westrik/MFW007B/README.md

# MFW007B
NA-01 Rev B (for JLCPCB assembly)
