westrik/MFW007B/MFW007B.kicad_pcb

## KiCad design MFW007B.kicad_pcb (2021-06-15)

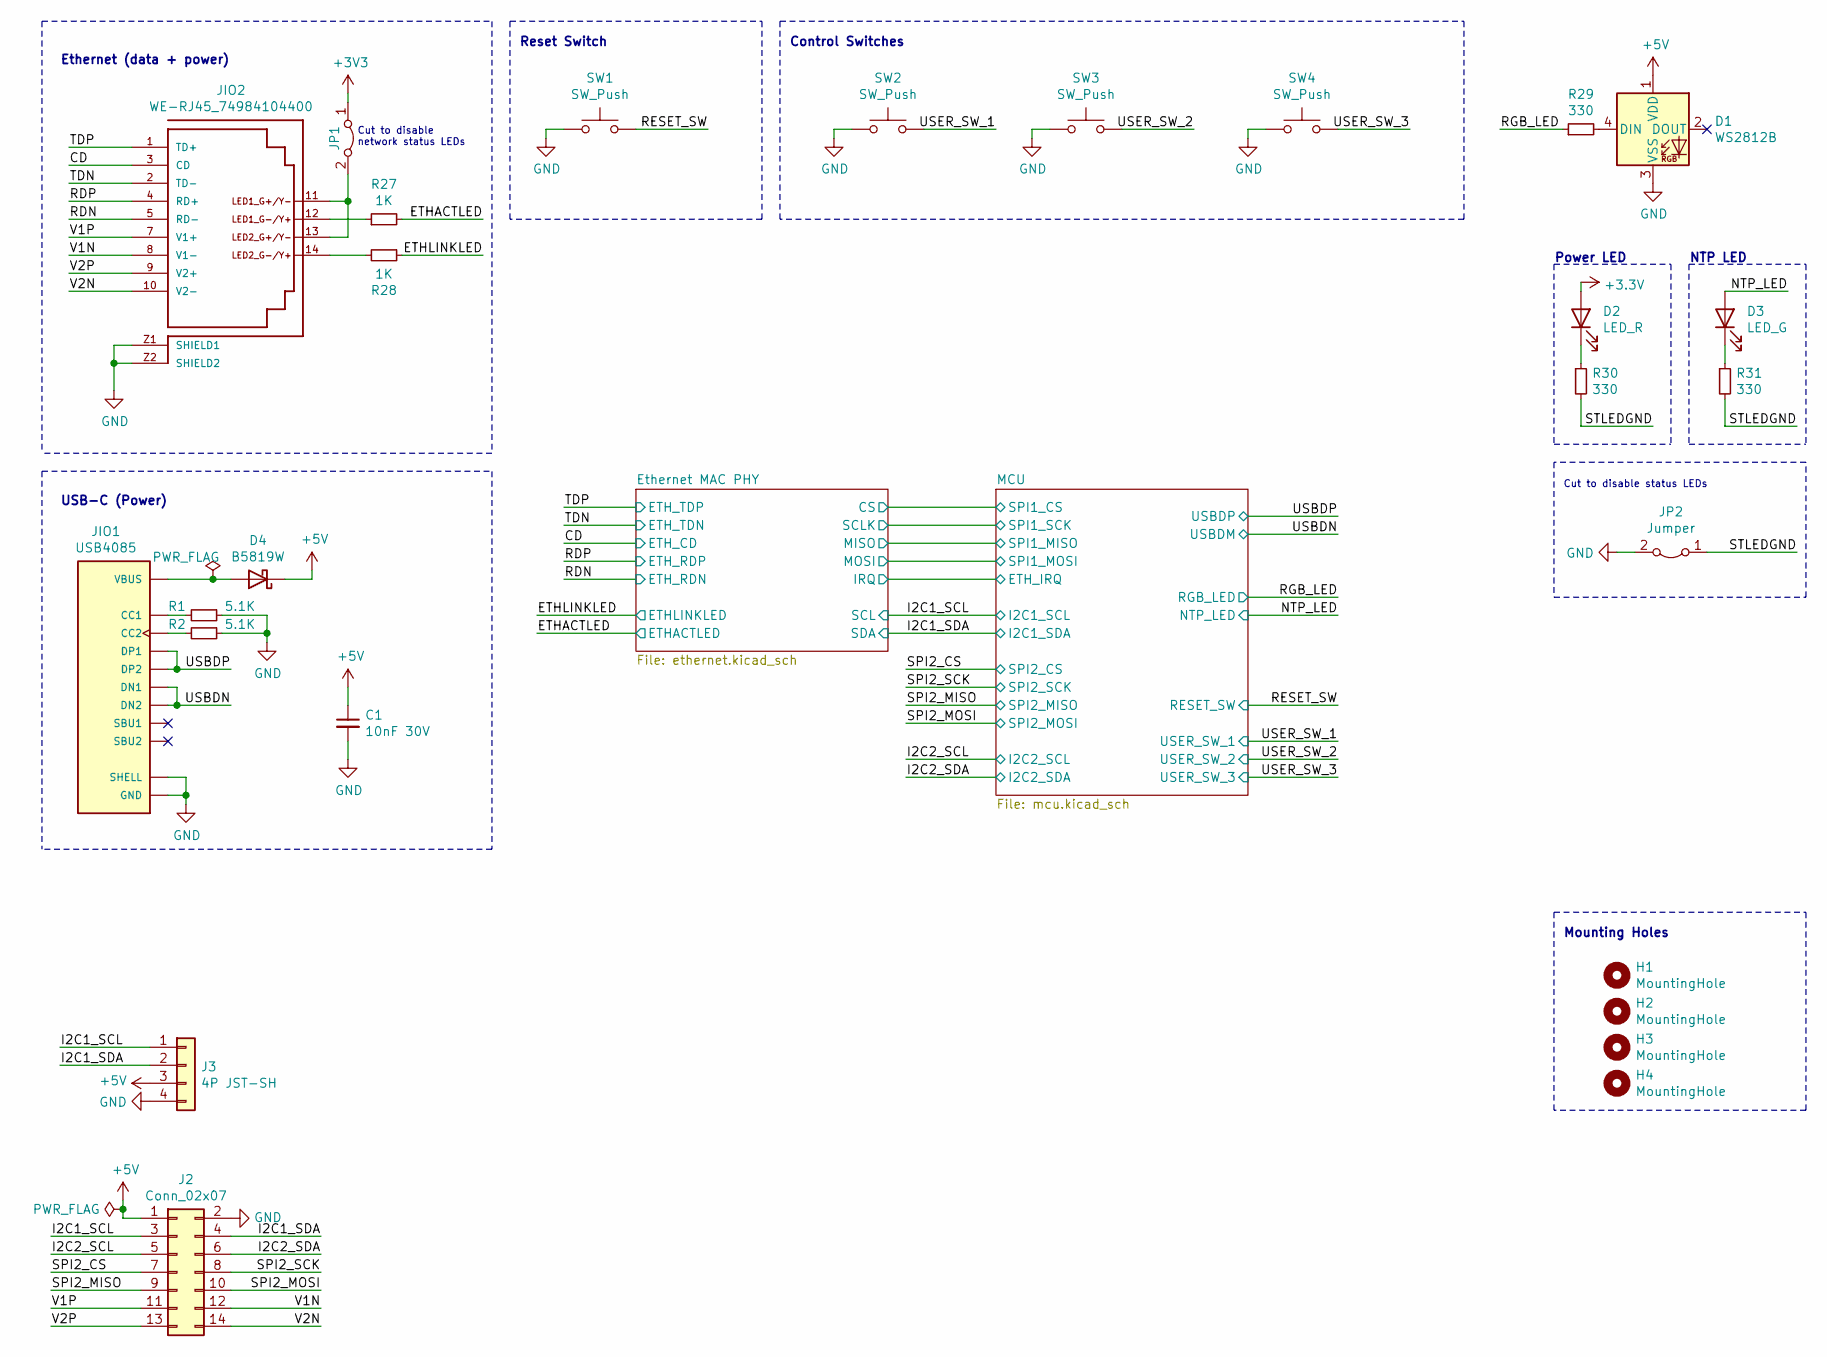
[picture p1: schematic MFW007B.kicad_sch, NA-01 Time Computer]

Parts:
C1: 10nF 30V; C_0805_2012Metric; LCSC Part Number C1710
D1: WS2812B; LED_WS2812B_PLCC4_5.0x5.0mm_P3.2mm; LCSC Part Number N/A
D2: LED_R; LED_0603_1608Metric; LCSC Part Number C2286
D3: LED_G; LED_0603_1608Metric; LCSC Part Number C72043
D4: B5819W; D_SOD-123; LCSC Part Number C8598
H1, H2, H3, H4: MountingHole; MountingHole_2.7mm_M2.5; LCSC Part Number N/A
J2: Conn_02x07; PinHeader_2x07_P2.54mm_Vertical; LCSC Part Number N/A
J3: 4P JST-SH; JST_SH_SM04B-SRSS-TB_1x04-1MP_P1.00mm_Horizontal; LCSC Part Number N/A
JIO1: USB4085; GCT_USB4085-GF-A_REVA; Manufacturer Part Number green/yellow-green/yellow; LCSC Part Number N/A
JIO2: WE-RJ45_74984104400; 74984104400; PART-NUMBER 74984104400; LCSC Part Number N/A
JP1, JP2: Jumper; SolderJumper-2_P1.3mm_Bridged_RoundedPad1.0x1.5mm; LCSC Part Number N/A
R1, R2: 5.1K; R_0402_1005Metric; LCSC Part Number C25905
R27, R28: 1K; R_0402_1005Metric
R29, R30, R31: 330; R_0402_1005Metric
SW1, SW2, SW3, SW4: SW_Push; PTS647SK38SMTR2LFS; LCSC Part Number N/A

Connections:
+5V: C1.1, D1.1 (VDD), D4.1 (K), J2.1, J3.3; also elsewhere on the board
/CD: JIO2.3 (CD); also elsewhere on the board
/ETHACTLED: R27.2; also elsewhere on the board
/ETHLINKLED: R28.1; also elsewhere on the board
/I2C1_SCL: J2.3, J3.1; also elsewhere on the board
/I2C1_SDA: J2.4, J3.2; also elsewhere on the board
/I2C2_SCL: J2.5; also elsewhere on the board
/I2C2_SDA: J2.6; also elsewhere on the board
/NTP_LED: D3.2 (A); also elsewhere on the board
/RDN: JIO2.5 (RD-); also elsewhere on the board
/RDP: JIO2.4 (RD+); also elsewhere on the board
/RESET_SW: SW1.2; also elsewhere on the board
/RGB_LED: R29.1; also elsewhere on the board
/SPI2_CS: J2.7; also elsewhere on the board
/SPI2_MISO: J2.9; also elsewhere on the board
/SPI2_MOSI: J2.10; also elsewhere on the board
/SPI2_SCK: J2.8; also elsewhere on the board
/STLEDGND: JP2.1 (A), R30.2, R31.2
/TDN: JIO2.2 (TD-); also elsewhere on the board
/TDP: JIO2.1 (TD+); also elsewhere on the board
/USBDN: JIO1.A7 (DN1), JIO1.B7 (DN2); also elsewhere on the board
/USBDP: JIO1.A6 (DP1), JIO1.B6 (DP2); also elsewhere on the board
/USER_SW_1: SW2.2; also elsewhere on the board
/USER_SW_2: SW3.2; also elsewhere on the board
/USER_SW_3: SW4.2; also elsewhere on the board
/V1N: J2.12, JIO2.8 (V1-)
/V1P: J2.11, JIO2.7 (V1+)
/V2N: J2.14, JIO2.10 (V2-)
/V2P: J2.13, JIO2.9 (V2+)
GND: C1.2, D1.3 (VSS), J2.2, J3.4, JIO1.A1 (GND), JIO1.A12 (GND), JIO1.B1 (GND), JIO1.B12 (GND), JIO1.P1 (SHELL), JIO1.P2 (SHELL), JIO1.P3 (SHELL), JIO1.P4 (SHELL), JIO2.Z1 (SHIELD1), JIO2.Z2 (SHIELD2), JP2.2 (B), R1.1, R2.1, SW1.1, SW2.1, SW3.1, SW4.1; also elsewhere on the board
unnamed: D1.4 (DIN), R29.2
unnamed: D2.1 (K), R30.1
unnamed: D3.1 (K), R31.1
unnamed: D4.2 (A), JIO1.A4 (VBUS), JIO1.A9 (VBUS), JIO1.B4 (VBUS), JIO1.B9 (VBUS)
unnamed: JIO1.A5 (CC1), R1.2
unnamed: JIO1.B5 (CC2), R2.2
unnamed: JIO2.11, JIO2.13, JP1.2 (B)
unnamed: JIO2.12, R27.1
unnamed: JIO2.14, R28.2
no_connect_(D1-Pad2): D1.2 (DOUT)
no_connect_(JIO1-PadA8): JIO1.A8 (SBU1)
no_connect_(JIO1-PadB8): JIO1.B8 (SBU2)

Notes on the sheet:
Ethernet (data + power)
USB-C (Power)
Cut to disable network status LEDs
Reset Switch
Control Switches
Power LED
Cut to disable status LEDs
Mounting Holes
NTP LED

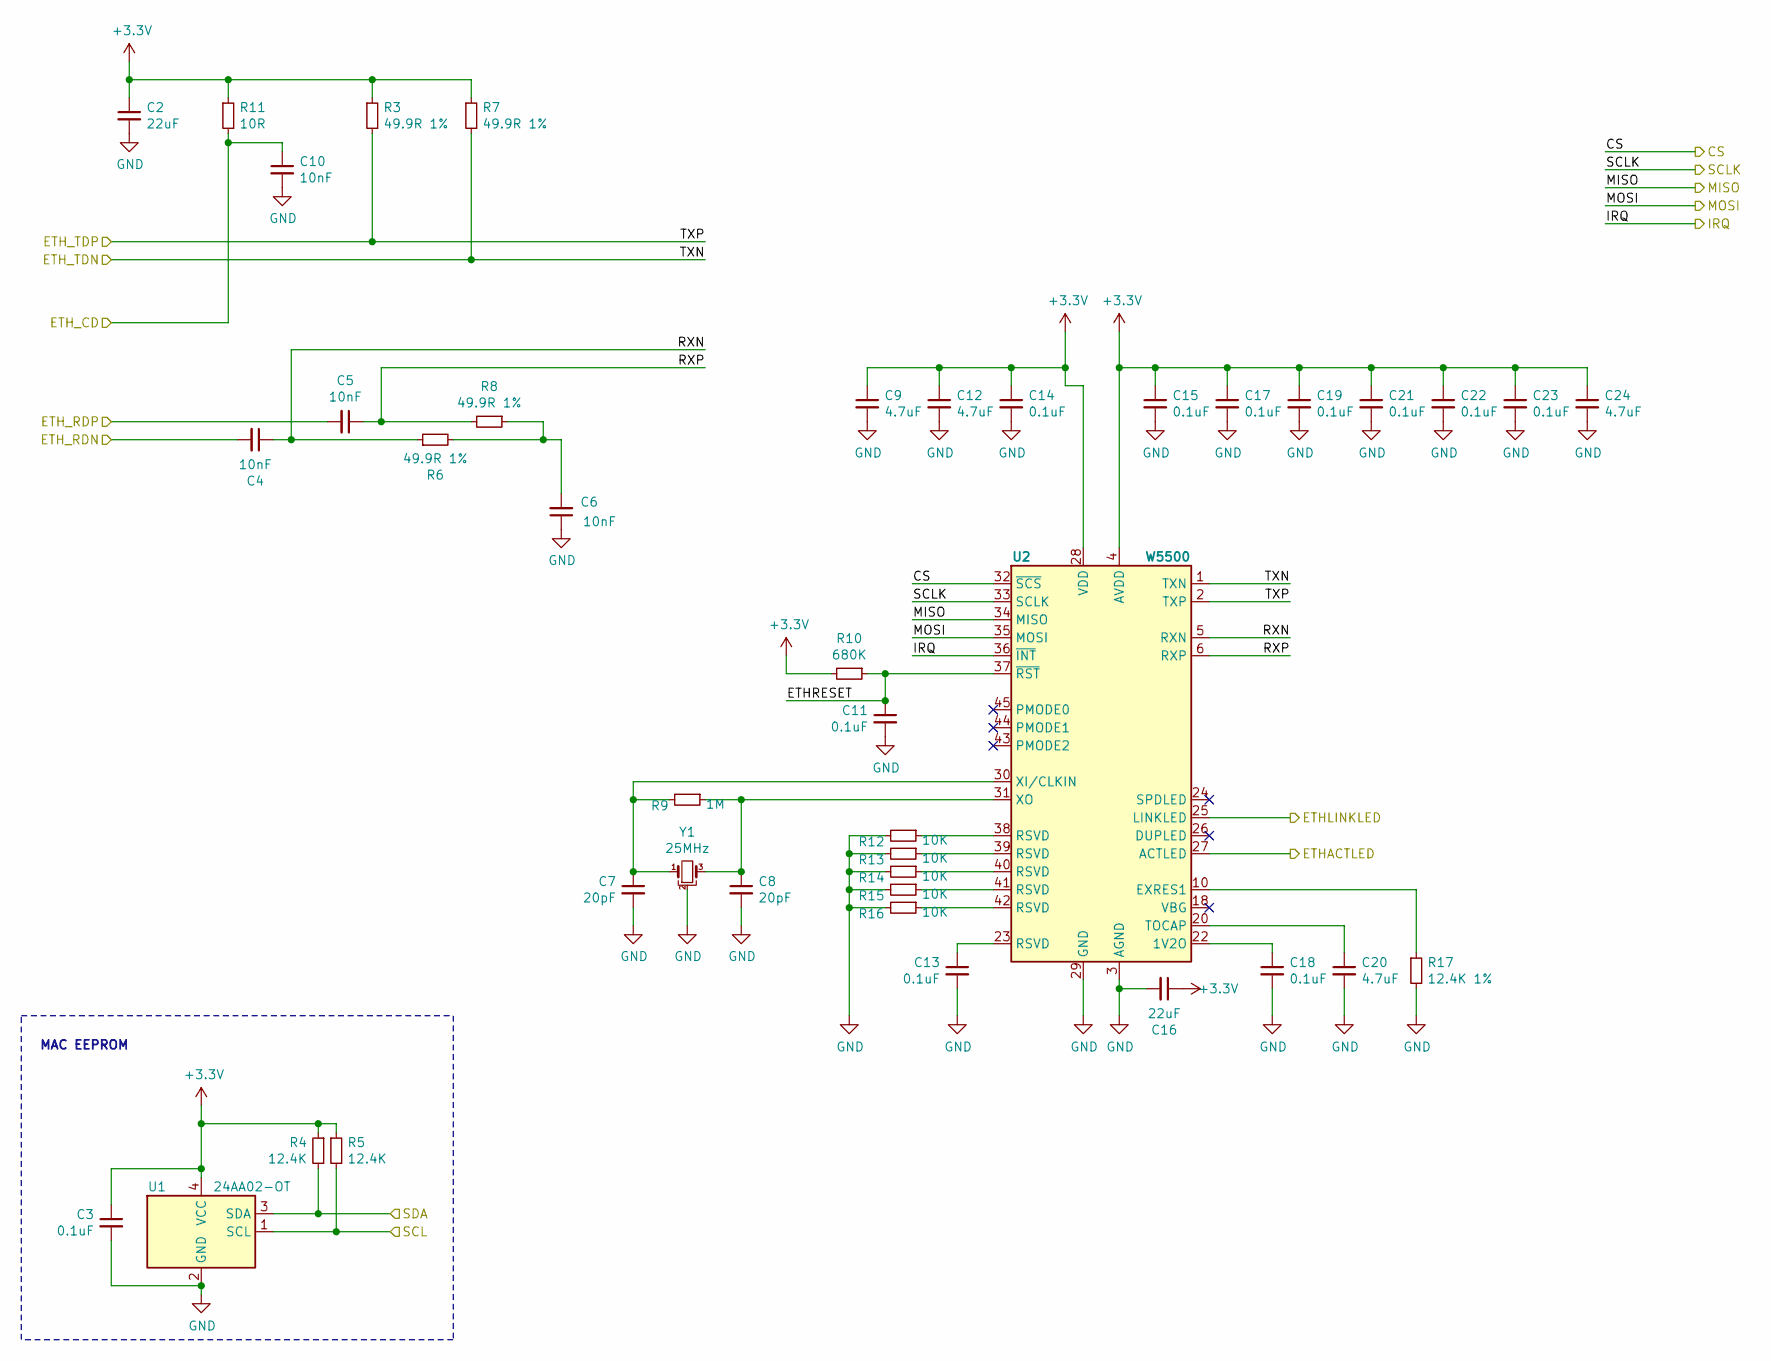
[picture p2: schematic ethernet.kicad_sch, NA-01 Time Computer]

Parts:
C2, C16: 22uF; C_0805_2012Metric; LCSC Part Number C59461
C3, C11, C13, C14, C15, C17, C18, C19, C21, C22, C23: 0.1uF; C_0402_1005Metric; LCSC Part Number C1525
C4, C5, C6, C10: 10nF; C_0402_1005Metric; LCSC Part Number C15195
C7, C8: 20pF; C_0402_1005Metric; LCSC Part Number C1554
C9, C12, C20, C24: 4.7uF; C_0402_1005Metric; LCSC Part Number C23733
R3, R6, R7, R8: 49.9R 1%; R_0402_1005Metric; LCSC Part Number C25120
R4, R5: 12.4K; R_0402_1005Metric
R9: 1M; R_0402_1005Metric
R10: 680K; R_0603_1608Metric
R11: 10R; R_0402_1005Metric
R12, R13, R14, R15, R16: 10K; R_0402_1005Metric
R17: 12.4K 1%; R_0402_1005Metric
U1: 24AA02-OT; SOT-23-5
U2: W5500; LQFP-48_7x7mm_P0.5mm
Y1: 25MHz; Crystal_SMD_3225-4Pin_3.2x2.5mm

Connections:
/CD: C10.1, R11.2; also elsewhere on the board
/ETHACTLED: U2.27 (ACTLED); also elsewhere on the board
/ETHLINKLED: U2.25 (LINKLED); also elsewhere on the board
/Ethernet MAC PHY/CS: U2.32 (~SCS); also elsewhere on the board
/Ethernet MAC PHY/ETHRESET: C11.1, R10.1, U2.37 (~RST)
/Ethernet MAC PHY/IRQ: U2.36 (~INT); also elsewhere on the board
/Ethernet MAC PHY/MISO: U2.34 (MISO); also elsewhere on the board
/Ethernet MAC PHY/MOSI: U2.35 (MOSI); also elsewhere on the board
/Ethernet MAC PHY/RXN: C4.1, R6.1, U2.5 (RXN)
/Ethernet MAC PHY/RXP: C5.1, R8.2, U2.6 (RXP)
/Ethernet MAC PHY/SCLK: U2.33 (SCLK); also elsewhere on the board
/I2C1_SCL: R5.2, U1.1 (SCL); also elsewhere on the board
/I2C1_SDA: R4.2, U1.3 (SDA); also elsewhere on the board
/RDN: C4.2; also elsewhere on the board
/RDP: C5.2; also elsewhere on the board
/TDN: R7.2, U2.1 (TXN); also elsewhere on the board
/TDP: R3.2, U2.2 (TXP); also elsewhere on the board
GND: C2.2, C3.2, C6.1, C7.2, C8.2, C9.2, C10.2, C11.2, C12.2, C13.2, C14.2, C15.2, C16.2, C17.2, C18.2, C19.2, C20.2, C21.2, C22.2, C23.2, C24.2, R12.2, R13.2, R14.2, R15.2, R16.2, R17.2, U1.2 (GND), U2.3 (AGND), U2.9 (AGND), U2.14 (AGND), U2.16 (AGND), U2.19 (AGND), U2.29 (GND), U2.48 (AGND), Y1.2; also elsewhere on the board
unnamed: C6.2, R6.2, R8.1
unnamed: C7.1, R9.2, U2.30 (XI/CLKIN), Y1.1
unnamed: C8.1, R9.1, U2.31 (XO), Y1.3
unnamed: C13.1, U2.23 (RSVD)
unnamed: C18.1, U2.22 (1V2O)
unnamed: C20.1, U2.20 (TOCAP)
unnamed: R12.1, U2.38 (RSVD)
unnamed: R13.1, U2.39 (RSVD)
unnamed: R14.1, U2.40 (RSVD)
unnamed: R15.1, U2.41 (RSVD)
unnamed: R16.1, U2.42 (RSVD)
unnamed: R17.1, U2.10 (EXRES1)
no_connect_(U1-Pad5): U1.5 (NC)
no_connect_(U2-Pad7): U2.7 (DNC)
no_connect_(U2-Pad12): U2.12 (NC)
no_connect_(U2-Pad13): U2.13 (NC)
no_connect_(U2-Pad18): U2.18 (VBG)
no_connect_(U2-Pad24): U2.24 (SPDLED)
no_connect_(U2-Pad26): U2.26 (DUPLED)
no_connect_(U2-Pad43): U2.43 (PMODE2)
no_connect_(U2-Pad44): U2.44 (PMODE1)
no_connect_(U2-Pad45): U2.45 (PMODE0)
no_connect_(U2-Pad46): U2.46 (NC)
no_connect_(U2-Pad47): U2.47 (NC)

Notes on the sheet:
MAC EEPROM

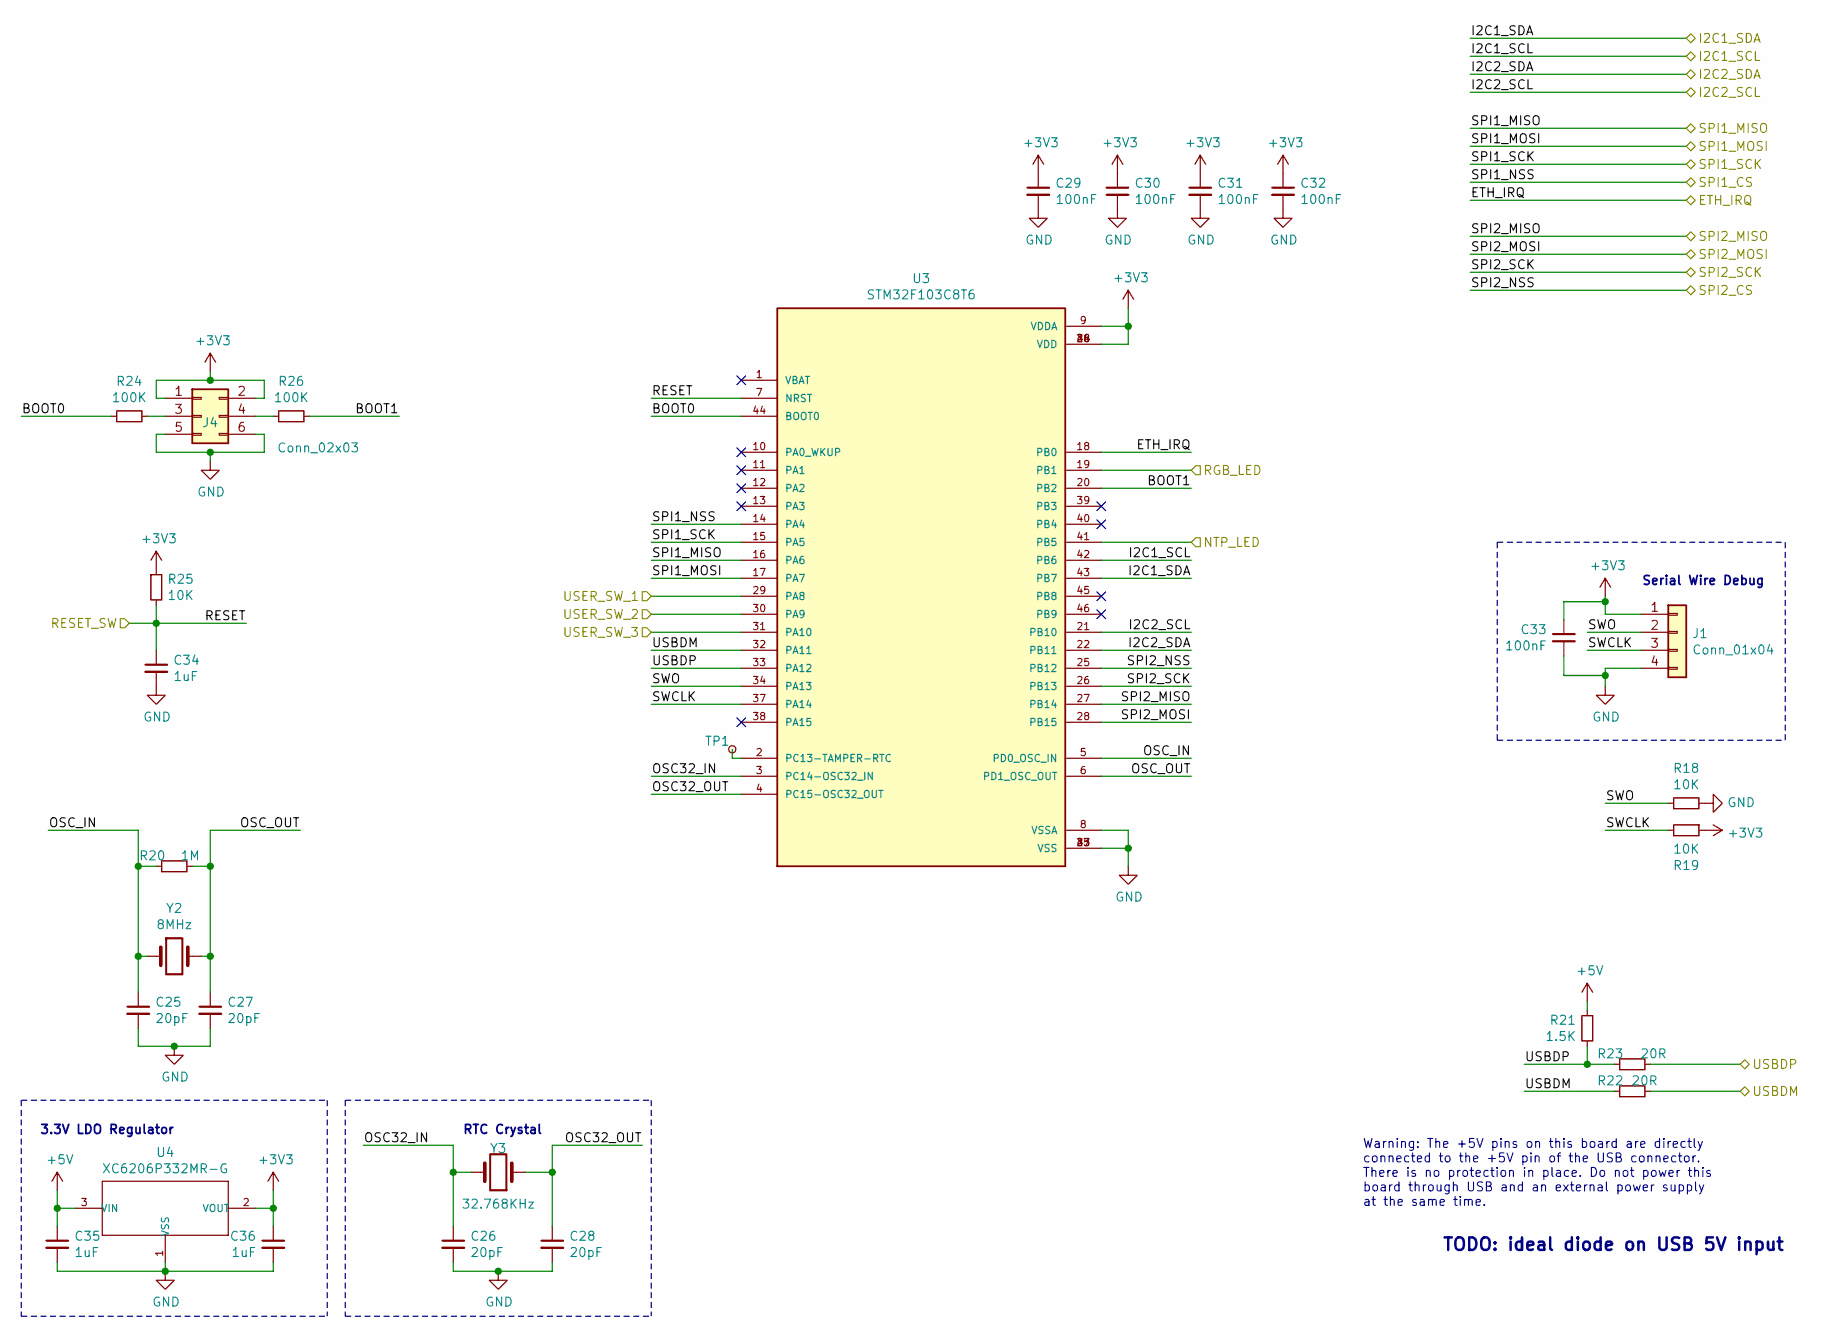
[picture p3: schematic mcu.kicad_sch, NA-01 Time Computer]

Parts:
C25, C26, C27, C28: 20pF; C_0402_1005Metric; LCSC Part Number C1554
C29, C30, C31, C32, C33: 100nF; C_0402_1005Metric; LCSC Part Number C1525
C34, C35, C36: 1uF; C_0402_1005Metric; LCSC Part Number C52923
J1: Conn_01x04; PinHeader_1x04_P2.54mm_Vertical; LCSC Part Number N/A
J4: Conn_02x03; PinHeader_2x03_P2.54mm_Vertical; LCSC Part Number N/A
R18, R19, R25: 10K; R_0402_1005Metric
R20: 1M; R_0402_1005Metric
R21: 1.5K; R_0402_1005Metric
R22, R23: 20R; R_0603_1608Metric
R24, R26: 100K; R_0402_1005Metric
TP1: TAMPER-RTC; TestPoint_Keystone_5010-5014_Multipurpose; LCSC Part Number N/A
U3: STM32F103C8T6; LQFP-48_7x7mm_P0.5mm; PARTREV 10
U4: XC6206P332MR-G; SOT-23; MPN XC6206P332MR-G; LCSC Part Number C5446
Y2: 8MHz; Crystal_SMD_5032-2Pin_5.0x3.2mm; Manufacturer Part Number X50328MSB2GI; LCSC Part Number C115962
Y3: 32.768KHz; Crystal_SMD_3215-2Pin_3.2x1.5mm; Manufacturer Part Number Q13FC1350000400; LCSC Part Number C32346

Connections:
+5V: C35.1, R21.1, U4.3 (VIN); also elsewhere on the board
/Ethernet MAC PHY/CS: U3.14 (PA4); also elsewhere on the board
/Ethernet MAC PHY/IRQ: U3.18 (PB0); also elsewhere on the board
/Ethernet MAC PHY/MISO: U3.16 (PA6); also elsewhere on the board
/Ethernet MAC PHY/MOSI: U3.17 (PA7); also elsewhere on the board
/Ethernet MAC PHY/SCLK: U3.15 (PA5); also elsewhere on the board
/I2C1_SCL: U3.42 (PB6); also elsewhere on the board
/I2C1_SDA: U3.43 (PB7); also elsewhere on the board
/I2C2_SCL: U3.21 (PB10); also elsewhere on the board
/I2C2_SDA: U3.22 (PB11); also elsewhere on the board
/MCU/BOOT0: R24.1, U3.44 (BOOT0)
/MCU/BOOT1: R26.2, U3.20 (PB2)
/MCU/OSC32_IN: C26.1, U3.3 (PC14-OSC32_IN), Y3.2
/MCU/OSC32_OUT: C28.1, U3.4 (PC15-OSC32_OUT), Y3.1
/MCU/OSC_IN: C25.1, R20.1, U3.5 (PD0_OSC_IN), Y2.1
/MCU/OSC_OUT: C27.1, R20.2, U3.6 (PD1_OSC_OUT), Y2.2
/MCU/SWCLK: J1.3, R19.2, U3.37 (PA14)
/MCU/SWO: J1.2, R18.1, U3.34 (PA13)
/NTP_LED: U3.41 (PB5); also elsewhere on the board
/RESET_SW: C34.1, R25.2, U3.7 (NRST); also elsewhere on the board
/RGB_LED: U3.19 (PB1); also elsewhere on the board
/SPI2_CS: U3.25 (PB12); also elsewhere on the board
/SPI2_MISO: U3.27 (PB14); also elsewhere on the board
/SPI2_MOSI: U3.28 (PB15); also elsewhere on the board
/SPI2_SCK: U3.26 (PB13); also elsewhere on the board
/USBDN: R22.1, R22.2, U3.32 (PA11); also elsewhere on the board
/USBDP: R21.2, R23.1, R23.2, U3.33 (PA12); also elsewhere on the board
/USER_SW_1: U3.29 (PA8); also elsewhere on the board
/USER_SW_2: U3.30 (PA9); also elsewhere on the board
/USER_SW_3: U3.31 (PA10); also elsewhere on the board
GND: C25.2, C26.2, C27.2, C28.2, C29.2, C30.2, C31.2, C32.2, C33.2, C34.2, C35.2, C36.2, J1.4, J4.5, J4.6, R18.2, U3.8 (VSSA), U3.23 (VSS), U3.35 (VSS), U3.47 (VSS), U4.1 (VSS); also elsewhere on the board
unnamed: J4.3, R24.2
unnamed: J4.4, R26.1
unnamed: TP1.1, U3.2 (PC13-TAMPER-RTC)
no_connect_(U3-Pad1): U3.1 (VBAT)
no_connect_(U3-Pad10): U3.10 (PA0_WKUP)
no_connect_(U3-Pad11): U3.11 (PA1)
no_connect_(U3-Pad12): U3.12 (PA2)
no_connect_(U3-Pad13): U3.13 (PA3)
no_connect_(U3-Pad38): U3.38 (PA15)
no_connect_(U3-Pad39): U3.39 (PB3)
no_connect_(U3-Pad40): U3.40 (PB4)
no_connect_(U3-Pad45): U3.45 (PB8)
no_connect_(U3-Pad46): U3.46 (PB9)

Notes on the sheet:
3.3V LDO Regulator
RTC Crystal
Warning: The +5V pins on this board are directly connected to the +5V pin of the USB connector. There is no protection in place. Do not power this board through USB and an external power supply at the same time.
Serial Wire Debug
TODO: ideal diode on USB 5V input

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
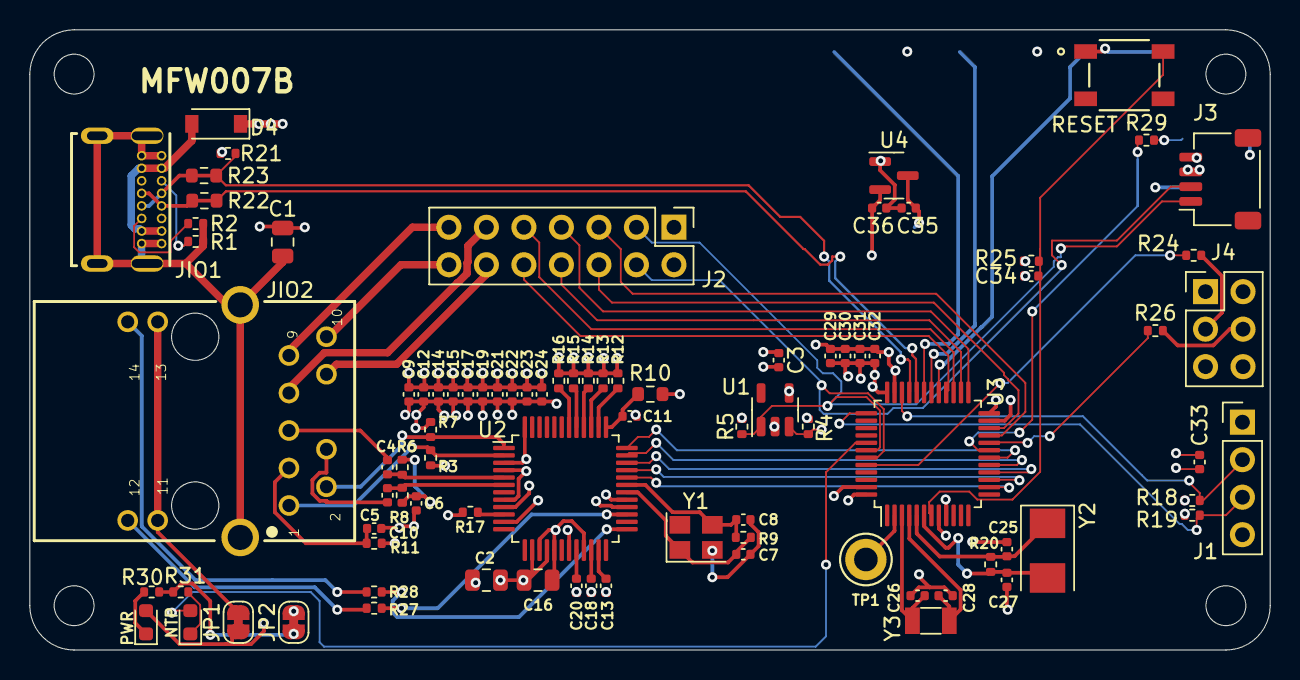
[picture p4: board MFW007B.kicad_pcb from above]

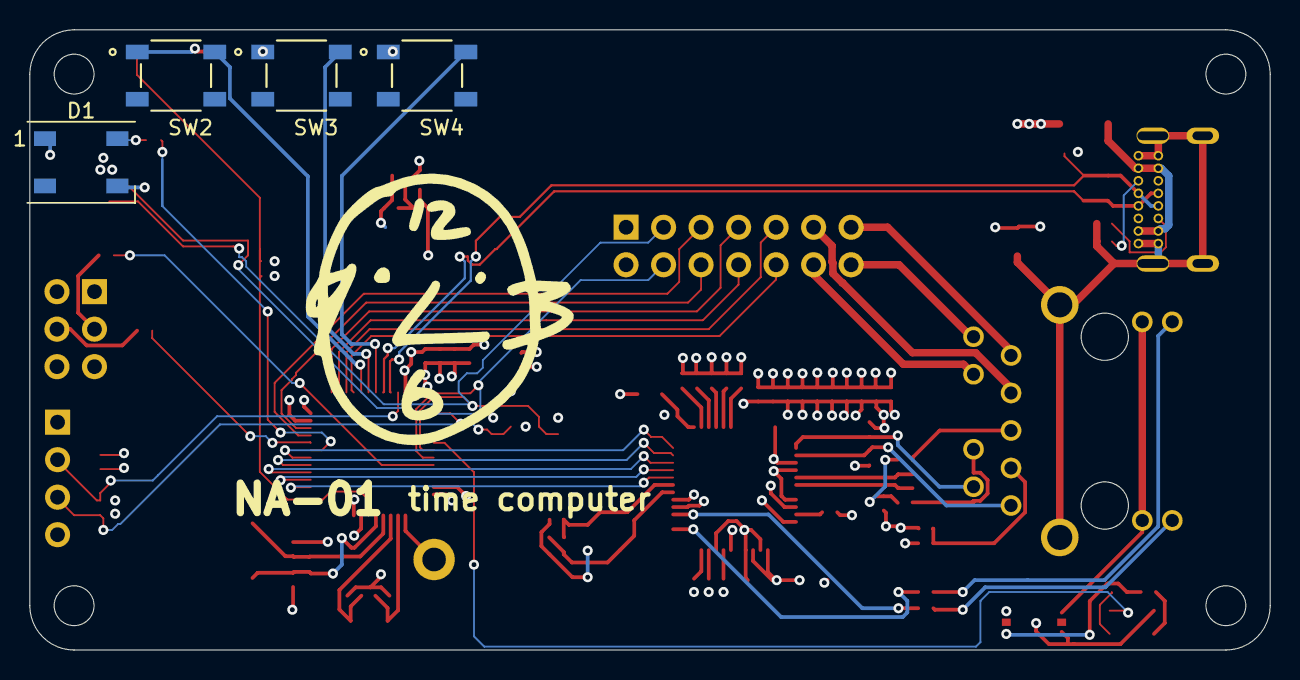
[picture p5: board MFW007B.kicad_pcb from below]

Board: 4 copper layers, 84.0 x 42.0 mm, 95 parts (4 on the bottom side), 71 nets.
