westrik/MFW007B/TODO.md

- [x] set up STM32
- [x] set up W5500
- [x] set up TPS23753A
- [ ] replace 0603 with 0402 basic (where possible)
- [ ] hook up LEDs + switches
- [ ] route everything
