westrik/MFW007B/(commit log)

2021-02-21 import relevant sections of MFW007A
    [MFW007B.kicad_pcb, MFW007B.kicad_sch, MFW007B.sch, ethernet.kicad_sch, mcu.kicad_sch]
2021-03-25 update 2021-03-25
    [MFW007B.kicad_pcb, MFW007B.kicad_sch, mcu.kicad_sch, poe.kicad_sch]
2021-03-26 update PoE
    [MFW007B.kicad_sch, poe.kicad_sch]
2021-03-26 hook up STM32
    [MFW007B.kicad_sch, mcu.kicad_sch, poe.kicad_sch]
2021-03-26 fix some lingering issues
    [MFW007B.kicad_sch, ethernet.kicad_sch, mcu.kicad_sch]
2021-03-26 hook up mac eeprom to i2c
    [MFW007B.kicad_sch, ethernet.kicad_sch]
2021-03-27 fix label assignments and add 2x7 header
    [MFW007B.kicad_pcb, MFW007B.kicad_sch, ethernet.kicad_sch, mcu.kicad_sch]
2021-03-28 finish porting blue pill schematic
    [MFW007B.kicad_sch, mcu.kicad_sch]
2021-03-30 rough component placement
    [MFW007B.kicad_pcb, MFW007B.kicad_sch, ethernet.kicad_sch, mcu.kicad_sch]
2021-03-30 refining component placement
    [MFW007B.kicad_pcb]
2021-05-30 start routing
    [MFW007B.kicad_pcb]
2021-05-30 rotate mcu
    [MFW007B.kicad_pcb]
2021-05-30 remove duplicate components
    [MFW007B.kicad_pcb]
2021-06-08 more routing
    [MFW007B.kicad_pcb]
2021-06-08 add gnd + 3.3v fills
    [MFW007B.kicad_pcb]
2021-06-08 connect to planes
    [MFW007B.kicad_pcb]
2021-06-08 finetune routing
    [MFW007B.kicad_pcb]
2021-06-08 fix DRC
    [MFW007B.kicad_pcb]
2021-06-13 order PCB
    [MFW007B-B_Mask.gbr, MFW007B-B_Paste.gbr, MFW007B-B_Silkscreen.gbr, MFW007B-Back.gbr, MFW007B-Edge_Cuts.gbr, MFW007B-F_Mask.gbr, MFW007B-F_Paste.gbr, MFW007B-F_Silkscreen.gbr]
2021-06-14 add some part numbers to schematic
    [MFW007B.kicad_sch, ethernet.kicad_sch, mcu.kicad_sch]
2021-06-15 fix vias
    [MFW007B-B_Mask.gbr, MFW007B-B_Paste.gbr, MFW007B-B_Silkscreen.gbr, MFW007B-Back.gbr, MFW007B-Edge_Cuts.gbr, MFW007B-F_Mask.gbr, MFW007B-F_Paste.gbr, MFW007B-F_Silkscreen.gbr]
